dl9sec/MFJ-993WWRC/Hardware/MFJ-993WWRC_1v0_Schematic.pdf

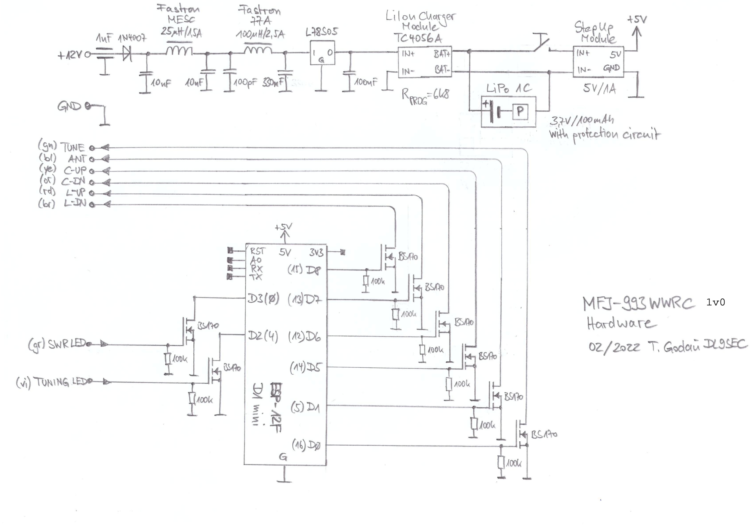
[picture p9: page 1]
