dl9sec/MFJ-993WWRC/(notices)

Notices in the files:
Arduino/MFJ-993WWRC_1v1/MFJ-993WWRC_1v1.ino:
This program is free software: you can redistribute it and/or modify
it under the terms of the GNU General Public License as published by
the Free Software Foundation, either version 3 of the License, or
(at your option) any later version.
